tofergregg/IBM-Wheelwriter-Hack/hardware/Arduino_NanoShield/meta/info.html

This project template is the basis of an expansion board for the Arduino Nano (http://arduino.cc/en/Main/ArduinoBoardNano)

This base project includes a PCB edge defined as the same
size as the Arduino Nano 2 PCB with the connectors placed
correctly to align the two boards.

Contours and holes can be easely modified, just remove line or hole
and redraw wath you want in layer "edge.cuts".
In layer "Dwgs.User" you have the position of Reset button,
USB, ISP and Power connector,

The final PCB looks like the following:

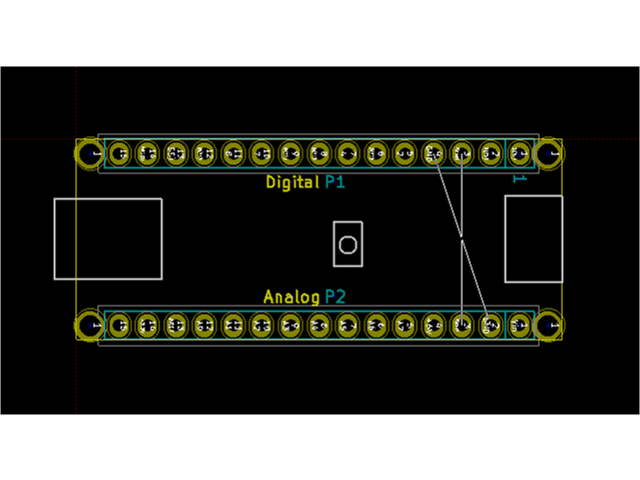
[picture p4: hardware/Arduino_NanoShield/meta/brd.png]


(c)2015 Jonathan Iapicco.
