tofergregg/IBM-Wheelwriter-Hack/images/case_in_line.pdf

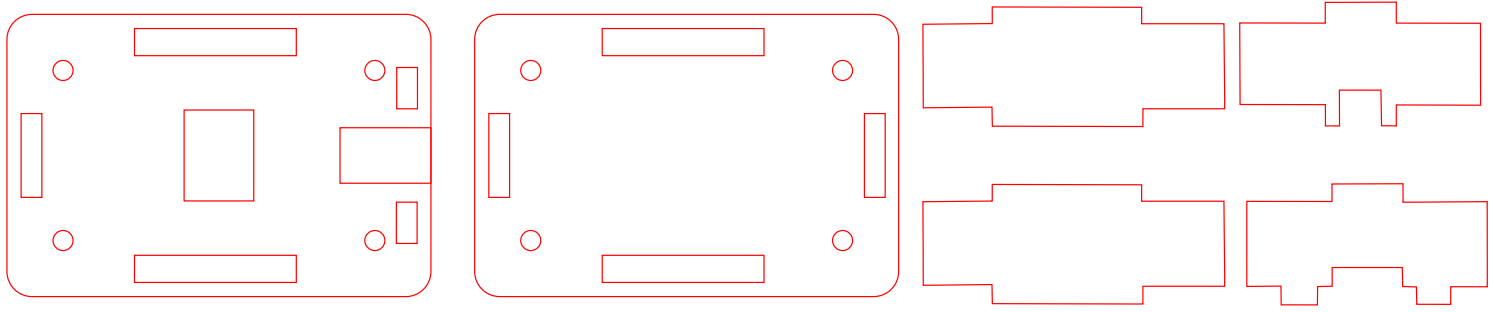
[picture p5: figure]
