tofergregg/IBM-Wheelwriter-Hack/FlatFlexPassthrough/flatflex_cable.jpg

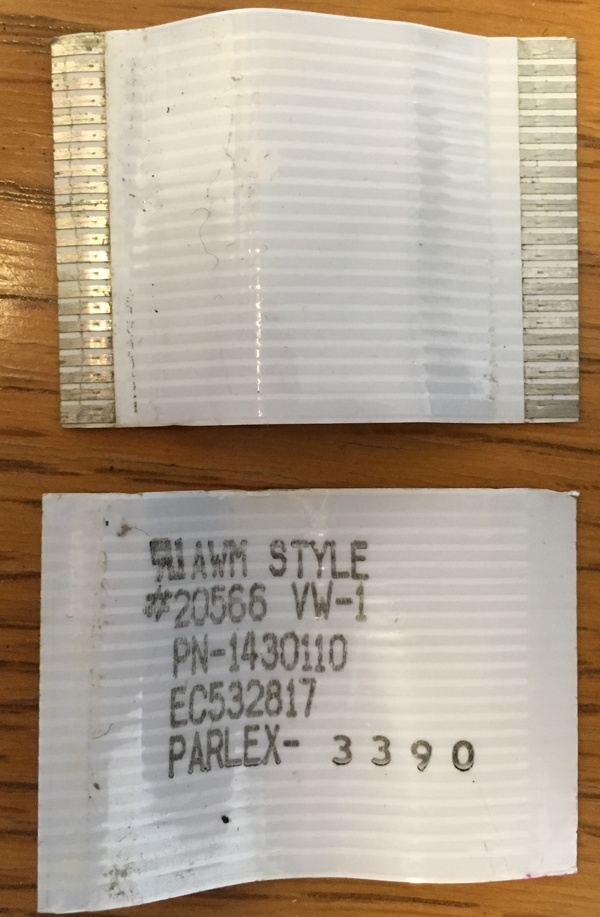
FlatFlexPassthrough/flatflex_cable.jpg
