tofergregg/IBM-Wheelwriter-Hack/images/earth.png

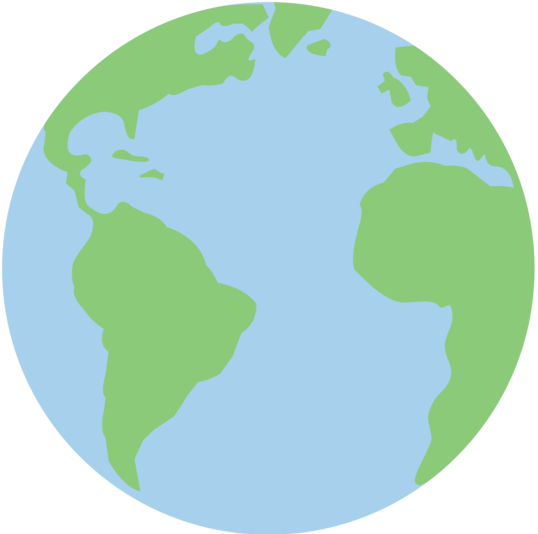
images/earth.png
