tofergregg/IBM-Wheelwriter-Hack/images/happyMac.jpg

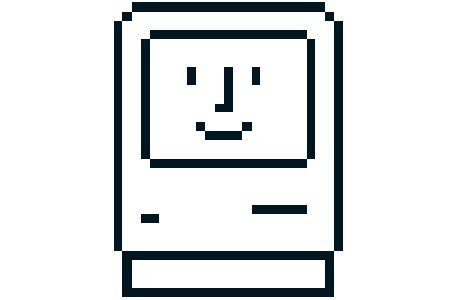
images/happyMac.jpg
