tofergregg/IBM-Wheelwriter-Hack/images/mario.png

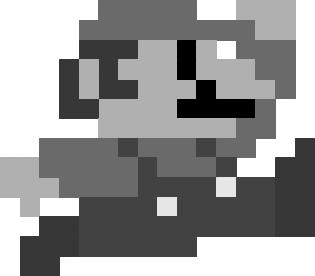
images/mario.png
