tofergregg/IBM-Wheelwriter-Hack/images/smiley.png

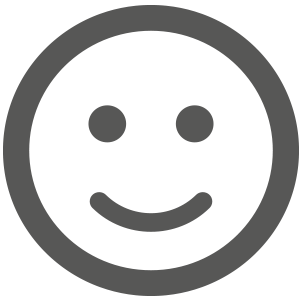
images/smiley.png
