tofergregg/IBM-Wheelwriter-Hack/images/wreck-it-ralph.gif

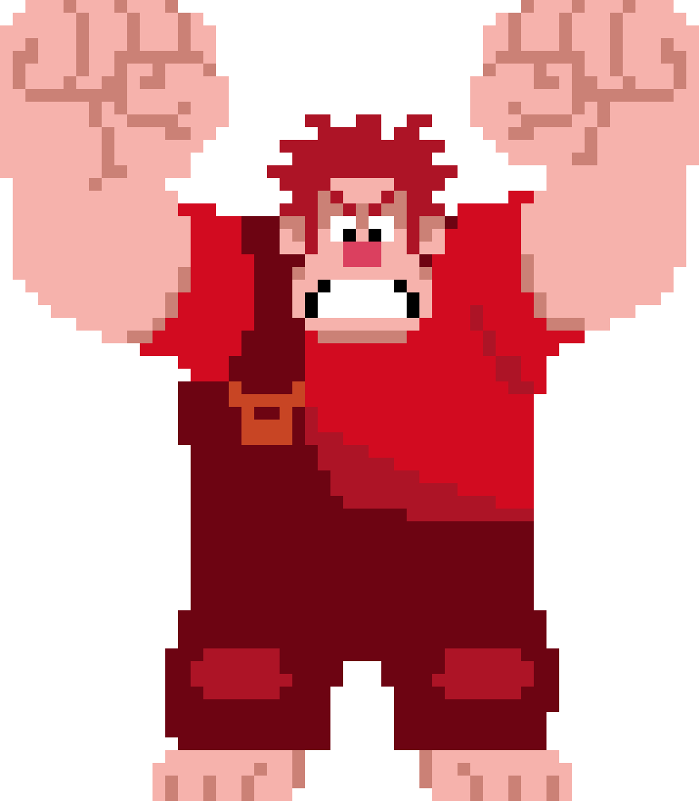
images/wreck-it-ralph.gif
