tofergregg/IBM-Wheelwriter-Hack/ROM/flex1.jpg

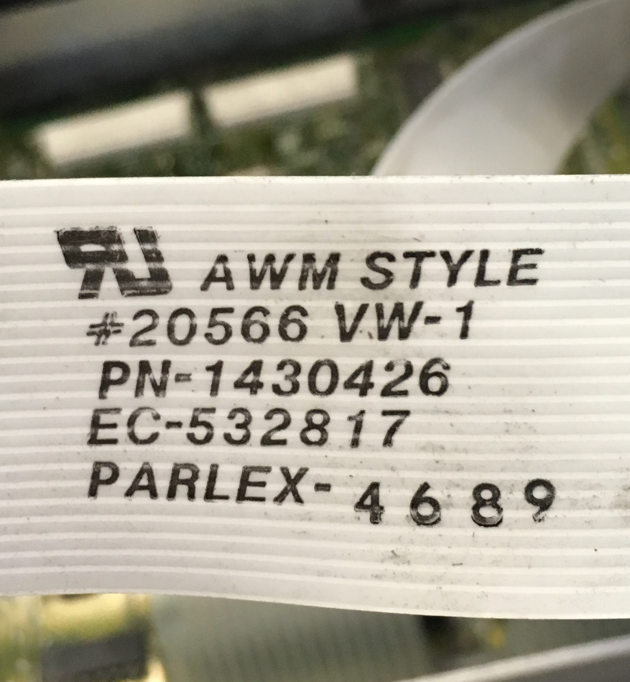
ROM/flex1.jpg
