tofergregg/IBM-Wheelwriter-Hack/ROM/flex2.jpg

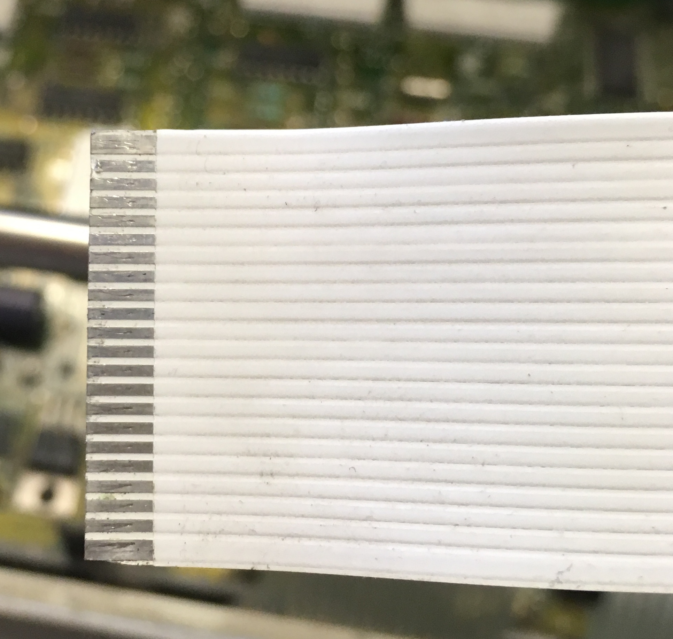
ROM/flex2.jpg
