tofergregg/IBM-Wheelwriter-Hack/ROM/full-pcb-board.jpg

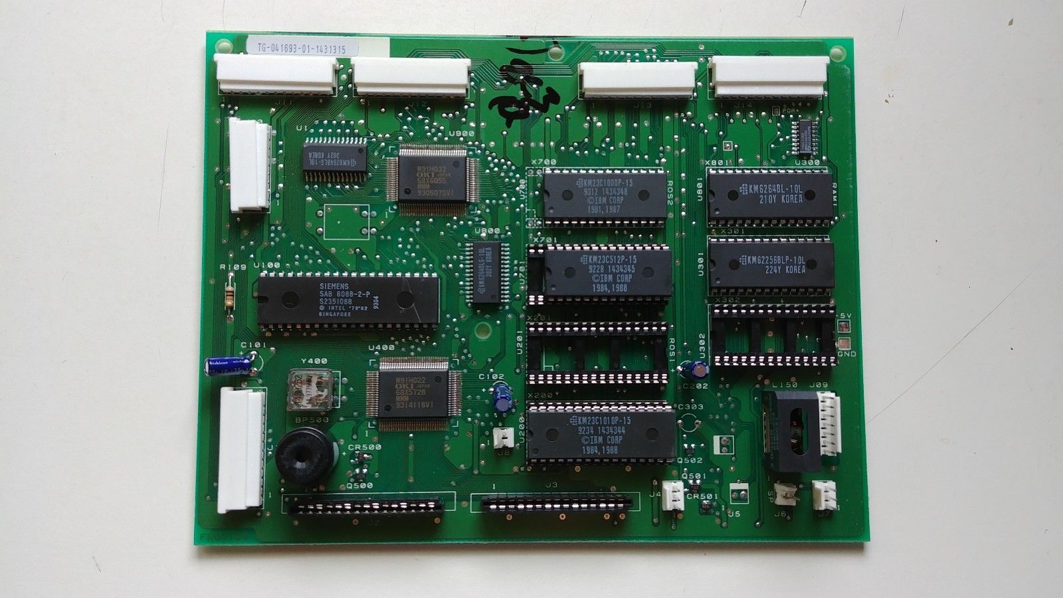
ROM/full-pcb-board.jpg
