tofergregg/IBM-Wheelwriter-Hack/software/IBM Wheelwriter Word Processor/bold.png

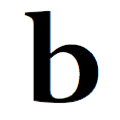
software/IBM Wheelwriter Word Processor/bold.png
