tofergregg/IBM-Wheelwriter-Hack/software/IBM Wheelwriter Word Processor/margins.png

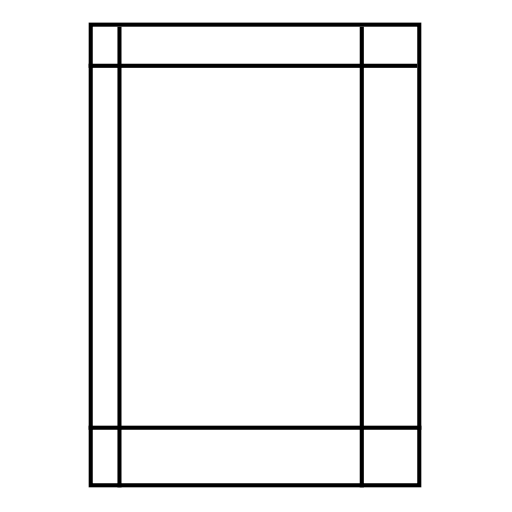
software/IBM Wheelwriter Word Processor/margins.png
