tofergregg/IBM-Wheelwriter-Hack/software/IBM Wheelwriter Word Processor/typewriter.png

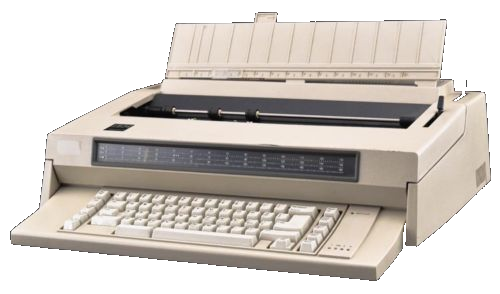
software/IBM Wheelwriter Word Processor/typewriter.png
