tofergregg/IBM-Wheelwriter-Hack/software/IBM Wheelwriter Word Processor/underline.png

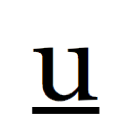
software/IBM Wheelwriter Word Processor/underline.png
