tofergregg/IBM-Wheelwriter-Hack/reverse_engineering/letters/Logic/imagePrint/2x2.csv

Time[s] | Channel 7
-0.100000000000000 | 1
0.000000000000000 | 0
0.000005000000000 | 1
0.000009750000000 | 0
0.000030000000000 | 1
0.000035750000000 | 0
0.000046000000000 | 1
0.000119500000000 | 0
0.000173000000000 | 1
0.000179250000000 | 0
0.000184250000000 | 1
0.000195000000000 | 0
0.000200000000000 | 1
0.000205750000000 | 0
0.000232000000000 | 1
0.000365000000000 | 0
0.000418250000000 | 1
0.000424500000000 | 0
0.000429500000000 | 1
0.000434250000000 | 0
0.000454500000000 | 1
0.000460250000000 | 0
0.000470500000000 | 1
0.000525000000000 | 0
0.000578250000000 | 1
0.000584500000000 | 0
0.000589500000000 | 1
0.000594250000000 | 0
0.000604500000000 | 1
0.000610250000000 | 0
0.000636250000000 | 1
0.000759500000000 | 0
0.000813000000000 | 1
0.000819000000000 | 0
0.000870000000000 | 1
0.000908750000000 | 0
0.000962250000000 | 1
0.000968500000000 | 0
0.000973500000000 | 1
0.000978250000000 | 0
0.000998500000000 | 1
0.001004250000000 | 0
0.001014500000000 | 1
0.001154250000000 | 0
0.001207500000000 | 1
0.001213750000000 | 0
0.001223750000000 | 1
0.001229500000000 | 0
0.001234750000000 | 1
0.001240500000000 | 0
0.001266500000000 | 1
0.001324750000000 | 0
0.001378250000000 | 1
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
