tofergregg/IBM-Wheelwriter-Hack/reverse_engineering/letters/Logic/imagePrint/abcde.csv

Time[s] | Channel 7
-0.100000000000000 | 1
0.000000000000000 | 0
0.000005000000000 | 1
0.000009750000000 | 0
0.000030000000000 | 1
0.000035750000000 | 0
0.000045750000000 | 1
0.000129500000000 | 0
0.000182750000000 | 1
0.000189000000000 | 0
0.000194250000000 | 1
0.000204750000000 | 0
0.000210000000000 | 1
0.000215750000000 | 0
0.000241750000000 | 1
0.000310750000000 | 0
0.000364250000000 | 1
0.000370250000000 | 0
0.000375250000000 | 1
0.000380000000000 | 0
0.000400250000000 | 1
0.000406000000000 | 0
0.000416250000000 | 1
0.000534750000000 | 0
0.000588000000000 | 1
0.000594250000000 | 0
0.000599250000000 | 1
0.000610000000000 | 0
0.000646000000000 | 1
0.000705250000000 | 0
0.000758750000000 | 1
0.000764750000000 | 0
0.000770000000000 | 1
0.000774500000000 | 0
0.000815750000000 | 1
0.000908000000000 | 0
0.000961500000000 | 1
0.000967500000000 | 0
0.000977500000000 | 1
0.000983250000000 | 0
0.000988500000000 | 1
0.000994250000000 | 0
0.001020250000000 | 1
0.001052000000000 | 0
0.001105250000000 | 1
0.422538000000000 | 0
0.422543000000000 | 1
0.422547750000000 | 0
0.422568000000000 | 1
0.422573750000000 | 0
0.422584000000000 | 1
0.422658500000000 | 0
0.422711750000000 | 1
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
