tofergregg/IBM-Wheelwriter-Hack/FlatFlexPassthrough/printer_board.jpg

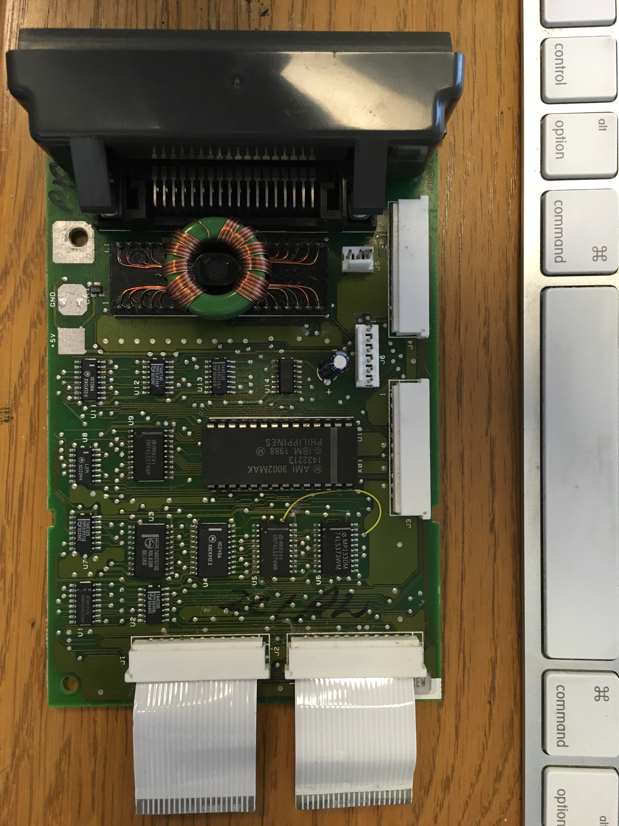
FlatFlexPassthrough/printer_board.jpg
