tofergregg/IBM-Wheelwriter-Hack/PrinterOption/testLinefeed.txt

This is a line of text.
JThis is a line of text.
The above lines should have printed twice but the
second line should have been 3 "pixels" lower.
This is another line of text.
JThis is another line of text.
The above lines should have printed twice but the
second line should have been 6 "pixels" lower.
This is another line of text.
JThis is another line of text.
The above lines should have printed twice but the
second line should have been 1 "pixel" lower.
