tofergregg/IBM-Wheelwriter-Hack/PrinterOption/test.txt

This is some stanard text without the carriage return.
So, we can pipe through sed to print correctly.
