tofergregg/IBM-Wheelwriter-Hack/PrinterOption/testBold.txt

This is regular text.

Ethis is boldF

this should not be bold
