tofergregg/IBM-Wheelwriter-Hack/PrinterOption/testEscapeCodes.txt

This is regular text.

Ethis is bold.F

this should not be bold.

-1this should be underlined.-0

this should not be underlined.

This should be ten squared plus five: 10S02T + 5

This should be water: HS12TO

This should be regular again.
