tofergregg/IBM-Wheelwriter-Hack/PrinterOption/testSuperscript.txt

This is regular text.

This should be ten squared plus five: 10S02T + 5

This should be water: HS12TO

This should be regular text again
