tofergregg/IBM-Wheelwriter-Hack/PrinterOption/testUnderline.txt

This is regular text.

this should be underlined
____ ______ __ __________

This should be regular again.

-1This should be underlined again.-0

This should not be underlined.
