tofergregg/IBM-Wheelwriter-Hack/reverse_engineering/letters/Logic/fast/test.txt

this is a fast test
and another fast line
and another.
