tofergregg/IBM-Wheelwriter-Hack/reverse_engineering/letters/Logic/13aBeanTest.csv

Time[s] | Channel 7
-0.100000000000000 | 1
0.000000000000000 | 0
0.000005250000000 | 1
0.000010000000000 | 0
0.000030250000000 | 1
0.000036000000000 | 0
0.000046000000000 | 1
0.000190750000000 | 0
0.000244250000000 | 1
0.020065000000000 | 0
0.020070000000000 | 1
0.020080750000000 | 0
0.020085750000000 | 1
0.020091500000000 | 0
0.020117500000000 | 1
0.020198750000000 | 0
0.020252000000000 | 1
0.021581000000000 | 0
0.021586250000000 | 1
0.021591000000000 | 0
0.021611000000000 | 1
0.021616750000000 | 0
0.021627000000000 | 1
0.021771750000000 | 0
0.021825250000000 | 1
0.021833750000000 | 0
0.021838750000000 | 1
0.021849500000000 | 0
0.021885500000000 | 1
0.021947750000000 | 0
0.022001000000000 | 1
0.022086250000000 | 0
0.022091500000000 | 1
0.022096250000000 | 0
0.022137250000000 | 1
0.022171750000000 | 0
0.022225000000000 | 1
0.022338250000000 | 0
0.022348250000000 | 1
0.022354000000000 | 0
0.022359250000000 | 1
0.022365000000000 | 0
0.022391000000000 | 1
0.022422250000000 | 0
0.022475750000000 | 1
0.172621750000000 | 0
0.172627000000000 | 1
0.172631750000000 | 0
0.172652000000000 | 1
0.172657500000000 | 0
0.172667750000000 | 1
0.192683000000000 | 0
0.192688000000000 | 1
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
