tofergregg/IBM-Wheelwriter-Hack/(threads)

Thread 2 (2017-02-06):

Schematic Documentation

Cabalist, 2017-02-06:
Would you consider adding some documentation about the circuit to the README?  The KiCAD files are great but I think for newbies it would be helpful to have a parts list and a picture of the circuit in the README.

Thanks!

Cabalist, 2017-02-06:
Related question.  You have +5v marked on the pinout of the connector to the typewriter and I currently have that disconnected and I'm not having any issues.   *Should* it be attached to something?

tofergregg, 2017-02-06:
Hi there -- sure, I could put documentation into the README. I'm glad you've got it working! No, actually the the 5V on the board was originally to power the Arduino, but then I realized that it wasn't necessary if you have USB power, which you'll have if you are using the port for serial access.

Please keep me posted on how it is going! Let me know if there are any issues. May I ask, what model Wheelwriter do you have? I am trying to compile a list of compatible models, and so far I only have my own Wheelwriter 6 on the list. Cheers!

Cabalist, 2017-02-06:
I've got a Wheelwriter 6 as well.  And a Wheelwriter 2 on the way.

I love your project and will keep you updated of any changes.  😃

tofergregg, 2017-02-06:
Great -- thank you!

tofergregg, 2017-02-09:
I put the breadboard diagram online, and updated the README with more information. Let me know if that works. Cheers!

Cabalist, 2017-02-10:
Love all the new info.

tofergregg, 2017-02-10:
Thanks -- let me know if you see anything else that needs changing / updating, or if you have suggestions. Incidentally, are you a Mac / Windows / Linux user?

Cabalist, 2017-02-10:
Mac/Linux

Will do on the suggestion front. I am going on a drive tomorrow to go pick
up a Wheelwriter 2 to see about compatibility.  I'm hacking away over here
and will put up the code I have soon.  I am working on a webclient and a
standalone unit.  :)

On Fri, Feb 10, 2017 at 6:45 AM, Chris Gregg <notifications@github.com>
wrote:

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

tofergregg, 2017-02-10:
Re: Web client -- awesome. Please let me know about compatibility with the Wheelwriter 2! I got a note from someone with a Wheelwriter 30 (a Lexmark variety?), and it doesn't look like it has an easily accessible port. Hopefully I can check that out at some point.

Closed 2017-02-09.

Thread 3 (2017-02-12):

Wheelwriter 5 Support

Cabalist, 2017-02-12:
Hey There,

I just confirmed Wheelwriter 5 support.  😀

Attached are some board shots.   The pinout of the connector appears to be the same and it immediately typed out some demo text for me without any adjustments to the code!

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

tofergregg, 2017-02-12:
Awesome! Thanks for the update, and very nice photos. Cheers!

Closed 2017-02-28.

Thread 5 (2017-02-12):

Complete Font Table

Cabalist, 2017-02-12:
I've managed to get my hands on 5 different font wheels.  I went through and compared all of them and found some omissions and errors in the asciiTrans section of the Arduino code.

All font wheels have the same characters and sadly there are no curly braces to be found.  Quine will not be possible in C 😉

This is the COMPLETE font table.  I went through the wheels by hand and looked at every letter.  There may be different WAYS of typing to discover but there aren't different THINGS to type.

My summary follows:

| Sequence | Hex  | Elite (1353861)| Title (1353952) | Delegate (1353843) | Courier 10 (1353511) | Prestige Elite (1353502)|                             |
|----------|------|-------|-------|----------|------------|----------------|-----------------------------|
| 1        | 0x01 | a     | a     | a        | a          | a              |                             |
| 2        | 0x02 | n     | n     | n        | n          | n              |                             |
| 3        | 0x03 | r     | r     | r        | r          | r              |                             |
| 4        | 0x04 | m     | m     | m        | m          | m              |                             |
| 5        | 0x05 | c     | c     | c        | c          | c              |                             |
| 6        | 0x06 | s     | s     | s        | s          | s              |                             |
| 7        | 0x07 | d     | d     | d        | d          | d              |                             |
| 8        | 0x08 | h     | h     | h        | h          | h              |                             |
| 9        | 0x09 | l     | l     | l        | l          | l              |                             |
| 10       | 0x0A | f     | f     | f        | f          | f              |                             |
| 11       | 0x0B | k     | k     | k        | k          | k              |                             |
| 12       | 0x0C | ,     | ,     | ,        | ,          | ,              |                             |
| 13       | 0x0D | V     | V     | V        | V          | V              |                             |
| 14       | 0x0E | -     | -     | -        | -          | -              |                             |
| 15       | 0x0F | G     | G     | G        | G          | G              |                             |
| 16       | 0x10 | U     | U     | U        | U          | U              |                             |
| 17       | 0x11 | F     | F     | F        | F          | F              |                             |
| 18       | 0x12 | B     | B     | B        | B          | B              |                             |
| 19       | 0x13 | Z     | Z     | Z        | Z          | Z              |                             |
| 20       | 0x14 | H     | H     | H        | H          | H              |                             |
| 21       | 0x15 | P     | P     | P        | P          | P              |                             |
| 22       | 0x16 | )     | )     | )        | )          | )              |                             |
| 23       | 0x17 | R     | R     | R        | R          | R              |                             |
| 24       | 0x18 | L     | L     | L        | L          | L              |                             |
| 25       | 0x19 | S     | S     | S        | S          | S              |                             |
| 26       | 0x1A | N     | N     | N        | N          | N              |                             |
| 27       | 0x1B | C     | C     | C        | C          | C              |                             |
| 28       | 0x1C | T     | T     | T        | T          | T              |                             |
| 29       | 0x1D | D     | D     | D        | D          | D              |                             |
| 30       | 0x1E | E     | E     | E        | E          | E              |                             |
| 31       | 0x1F | I     | I     | I        | I          | I              |                             |
| 32       | 0x20 | A     | A     | A        | A          | A              |                             |
| 33       | 0x21 | J     | J     | J        | J          | J              |                             |
| 34       | 0x22 | O     | O     | O        | O          | O              |                             |
| 35       | 0x23 | (     | (     | (        | (          | (              |                             |
| 36       | 0x24 | M     | M     | M        | M          | M              |                             |
| 37       | 0x25 | .     | .     | .        | .          | .              | Missing (duplicate of 0x57) |
| 38       | 0x26 | Y     | Y     | Y        | Y          | Y              |                             |
| 39       | 0x27 | ,     | ,     | ,        | ,          | ,              | Missing (duplicate of 0x0C) |
| 40       | 0x28 | /     | /     | /        | /          | /              |                             |
| 41       | 0x29 | W     | W     | W        | W          | W              |                             |
| 42       | 0x2A | 9     | 9     | 9        | 9          | 9              |                             |
| 43       | 0x2B | K     | K     | K        | K          | K              |                             |
| 44       | 0x2C | 3     | 3     | 3        | 3          | 3              |                             |
| 45       | 0x2D | X     | X     | X        | X          | X              |                             |
| 46       | 0x2E | 1     | 1     | 1        | 1          | 1              |                             |
| 47       | 0x2F | 2     | 2     | 2        | 2          | 2              |                             |
| 48       | 0x30 | 0     | 0     | 0        | 0          | 0              |                             |
| 49       | 0x31 | 5     | 5     | 5        | 5          | 5              |                             |
| 50       | 0x32 | 4     | 4     | 4        | 4          | 4              |                             |
| 51       | 0x33 | 6     | 6     | 6        | 6          | 6              |                             |
| 52       | 0x34 | 8     | 8     | 8        | 8          | 8              |                             |
| 53       | 0x35 | 7     | 7     | 7        | 7          | 7              |                             |
| 54       | 0x36 | *     | *     | *        | *          | *              |                             |
| 55       | 0x37 | $     | $     | $        | $          | $              |                             |
| 56       | 0x38 | #     | #     | #        | #          | #              |                             |
| 57       | 0x39 | %     | %     | %        | %          | %              |                             |
| 58       | 0x3A | ¢     | ¢     | ¢        | ¢          | ¢              | Missing                     |
| 59       | 0x3B | +     | +     | +        | +          | +              |                             |
| 60       | 0x3C | ±     | ±     | ±        | ±          | ±              | Missing                     |
| 61       | 0x3D | @     | @     | @        | @          | @              |                             |
| 62       | 0x3E | Q     | Q     | Q        | Q          | Q              |                             |
| 63       | 0x3F | &     | &     | &        | &          | &              |                             |
| 64       | 0x40 | ]     | ]     | ]        | ]          | ]              |                             |
| 65       | 0x41 | [     | [     | [        | [          | [              |                             |
| 66       | 0x42 | ²     | ²     | ²        | ²          | ²              | Missing                     |
| 67       | 0x43 | ³     | ³     | ³        | ³          | ³              | Missing                     |
| 68       | 0x44 | °     | °     | °        | °          | °              | Missing                     |
| 69       | 0x45 | §     | §     | §        | §          | §              | Missing                     |
| 70       | 0x46 | ¶     | ¶     | ¶        | ¶          | ¶              | Missing                     |
| 71       | 0x47 | ½     | ½     | ½        | ½          | ½              | Missing                     |
| 72       | 0x48 | ¼     | ¼     | ¼        | ¼          | ¼              | Missing                     |
| 73       | 0x49 | !     | !     | !        | !          | !              |                             |
| 74       | 0x4A | ?     | ?     | ?        | ?          | ?              |                             |
| 75       | 0x4B | "     | "     | "        | "          | "              |                             |
| 76       | 0x4C | '     | '     | '        | '          | '              |                             |
| 77       | 0x4D | =     | =     | =        | =          | =              |                             |
| 78       | 0x4E | :     | :     | :        | :          | :              |                             |
| 79       | 0x4F | _     | _     | _        | _          | _              |                             |
| 80       | 0x50 | ;     | ;     | ;        | ;          | ;              |                             |
| 81       | 0x51 | x     | x     | x        | x          | x              |                             |
| 82       | 0x52 | q     | p     | p        | p          | p              |                             |
| 83       | 0x53 | v     | v     | v        | v          | v              |                             |
| 84       | 0x54 | z     | z     | z        | z          | z              |                             |
| 85       | 0x55 | w     | w     | w        | w          | w              |                             |
| 86       | 0x56 | j     | j     | j        | j          | j              |                             |
| 87       | 0x57 | .     | .     | .        | .          | .              |                             |
| 88       | 0x58 | y     | y     | y        | y          | y              |                             |
| 89       | 0x59 | b     | d     | d        | d          | d              |                             |
| 90       | 0x5A | g     | g     | g        | g          | g              |                             |
| 91       | 0x5B | u     | u     | u        | u          | u              |                             |
| 92       | 0x5C | p     | q     | q        | q          | q              |                             |
| 93       | 0x5D | i     | i     | i        | i          | i              |                             |
| 94       | 0x5E | t     | t     | t        | t          | t              |                             |
| 95       | 0x5F | o     | o     | o        | o          | o              |                             |
| 96       | 0x60 | e     | e     | e        | e          | e              |                             |

Cabalist, 2017-02-12:
It is also worth noting that there are other very different fonts that were made available

Such as:
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

I am thinking a Compatibility table is in the future with Model and Printwheels...

tofergregg, 2017-02-12:
Wow -- thanks for the updated information (wait a minute...did you outbid me on an eBay listing for those wheels?? -- it looks like that listing included Letter Gothic, so probably not).

I'm surprised Courier doesn't have curly braces (did they really need § and ¶ ?). I was sure there would be modified letters (the Arabic wheel shows that there are completely different wheels). Alas.

I'm still flummoxed by the encoding (i.e., why 'a' is 0x1, b is 0x59, etc.). I wonder if it has to do with the frequency of letters in English -- having x, q, v, z, and w near each other is suspect, as is having i, t, o, and e next to each other. If we could only track down an engineer who originally worked on the Wheelwriter design...

Cabalist, 2017-02-12:
Oh!  The Encoding is actually really simple and I meant to point it out in the original post.  a is the first letter on the wheel, n is the second, etc.  There are 96 symbols on each wheel.   Haha.

Cabalist, 2017-02-12:
I've got 5 wheels if you would like me to send you one I totally can.

tofergregg, 2017-02-12:
Ah -- so interesting. I just looked at the wheel on mine and I see what you mean. I have a feeling that the code itself is related to letter frequency, because the top keys are aeoti (to the left) and rmcsb (to the right) -- pretty common letters.

No worries about the wheel -- I will get one soon. Thanks, though!

Cabalist, 2017-02-12:
Here are some updated examples of asciiTrans with formatting.  asciiTrans is kind of a misnomer as this has non-ascii symbols and is missing ascii symbols.   Maybe symbolTrans instead?

Sequential Order
```C
int asciiTrans[96] =
//   a        n        r        m        c        s        d        h
   {0x01,    0x02,    0x03,    0x04,    0x05,    0x06,    0x07,    0x08,
//   l        f        k        ,        V        -        G        U
    0x09,    0x0A,    0x0B,    0x0C,    0x0D,    0x0E,    0x0F,    0x10,
//   F        B        Z        H        P        )        R        L
    0x11,    0x12,    0x13,    0x14,    0x15,    0x16,    0x17,    0x18,
//   S        N        C        T        D        E        I        A
    0x19,    0x1A,    0x1B,    0x1C,    0x1D,    0x1E,    0x1F,    0x20,
//   J        O        (        M        .        Y        ,        /
    0x21,    0x22,    0x23,    0x24,    0x25,    0x26,    0x27,    0x28,
//   W        9        K        3        X        1        2        0
    0x29,    0x2A,    0x2B,    0x2C,    0x2D,    0x2E,    0x2F,    0x30,
//   5        4        6        8        7        *        $        #
    0x31,    0x32,    0x33,    0x34,    0x35,    0x36,    0x37,    0x38,
//   %        ¢        +        ±        @        Q        &        ]
    0x39,    0x3A,    0x3B,    0x3C,    0x3D,    0x3E,    0x3F,    0x40,
//   [        ²        ³        °        §        ¶        ½        ¼
    0x41,    0x42,    0x43,    0x44,    0x45,    0x46,    0x47,    0x48,
//   !        ?        "        '        =        :        _        ;
    0x49,    0x4A,    0x4B,    0x4C,    0x4D,    0x4E,    0x4F,    0x50,
//   x        q        v        z        w        j        .        y
    0x51,    0x52,    0x53,    0x54,    0x55,    0x56,    0x57,    0x58,
//   b        g        u        p        i        t        o        e
    0x59,    0x5A,    0x5B,    0x5C,    0x5D,    0x5E,    0x5F,    0x60}
```
Symbol order with grouping
```C
int asciiTrans[96] =
//   A        B        C        D        E        F        G        H
   {0x20,    0x12,    0x1B,    0x1D,    0x1E,    0x11,    0x0F,    0x14,
//   I        J        K        L        M        N        O        P
    0x1F,    0x21,    0x2B,    0x18,    0x24,    0x1A,    0x22,    0x15,
//   Q        R        S        T        U        V        W        X
    0x3E,    0x17,    0x19,    0x1C,    0x10,    0x0D,    0x29,    0x2D,
//   Y        Z        a        b        c        d        e        f
    0x26,    0x13,    0x01,    0x59,    0x05,    0x07,    0x60,    0x0A,
//   g        h        i        j        k        l        m        n
    0x5A,    0x08,    0x5D,    0x56,    0x0B,    0x09,    0x04,    0x02,
//   o        p        q        r        s        t        u        v
    0x5F,    0x5C,    0x52,    0x03,    0x06,    0x5E,    0x5B,    0x53,
//   w        x        y        z
    0x55,    0x51,    0x58,    0x54,

//   0        1        2        3        4        5        6        7
    0x30,    0x2E,    0x2F,    0x2C,    0x32,    0x31,    0x33,    0x35,
//   8        9
    0x34,    0x2A,

//   !        "        #        $        %        &        '        (
    0x49,    0x4B,    0x38,    0x37,    0x39,    0x3F,    0x4C,    0x23,
//   )        *        +        ,        ,        -        .        .
    0x16,    0x36,    0x3B,    0x27,    0x0C,    0x0E,    0x57,    0x25,
//   /        :        ;        =        ?        @        [        ]
    0x28,    0x4E,    0x50,    0x4D,    0x4A,    0x3D,    0x41,    0x40,
//   _        ¢        §        °        ±        ²        ³        ¶
    0x4F,    0x3A,    0x45,    0x44,    0x3C,    0x42,    0x43,    0x46,
//   ¼        ½
    0x48,    0x47}
 ```

Symbol order without grouping:
```C
int asciiTrans[96] =
//   A        B        C        D        E        F        G        H
   {0x20,    0x12,    0x1B,    0x1D,    0x1E,    0x11,    0x0F,    0x14,
//   I        J        K        L        M        N        O        P
    0x1F,    0x21,    0x2B,    0x18,    0x24,    0x1A,    0x22,    0x15,
//   Q        R        S        T        U        V        W        X
    0x3E,    0x17,    0x19,    0x1C,    0x10,    0x0D,    0x29,    0x2D,
//   Y        Z        a        b        c        d        e        f
    0x26,    0x13,    0x01,    0x59,    0x05,    0x07,    0x60,    0x0A,
//   g        h        i        j        k        l        m        n
    0x5A,    0x08,    0x5D,    0x56,    0x0B,    0x09,    0x04,    0x02,
//   o        p        q        r        s        t        u        v
    0x5F,    0x5C,    0x52,    0x03,    0x06,    0x5E,    0x5B,    0x53,
//   w        x        y        z        0        1        2        3
    0x55,    0x51,    0x58,    0x54,    0x30,    0x2E,    0x2F,    0x2C,
//   4        5        6        7        8        9        !        "
    0x32,    0x31,    0x33,    0x35,    0x34,    0x2A,    0x49,    0x4B,
//   #        $        %        &        '        (        )        *
    0x38,    0x37,    0x39,    0x3F,    0x4C,    0x23,    0x16,    0x36,
//   +        ,        ,        -        .        .        /        :
    0x3B,    0x27,    0x0C,    0x0E,    0x57,    0x25,    0x28,    0x4E,
//   ;        =        ?        @        [        ]        _        ¢
    0x50,    0x4D,    0x4A,    0x3D,    0x41,    0x40,    0x4F,    0x3A,
//   §        °        ±        ²        ³        ¶        ¼        ½
    0x45,    0x44,    0x3C,    0x42,    0x43,    0x46,    0x48,    0x47}
```

bitcraft, 2017-02-28:
nice work!

tofergregg, 2017-02-28:
I just received an OCR-A wheel, and interestingly, there are some differences. Funnily enough, there _are_ curly braces, but you use the parentheses keys, so there aren't any parentheses! At least I haven't found them yet. :/

There aren't any square brackets, either, nor an exclamation point, nor an underscore. So, my idea to print code with the typewriter seems slim at this point.

RussellSenior, 2020-04-26:
According to https://typewriters.com/supplies/genuine-ibm-printwheel/ there are "ASCII" printwheels. I have yet to actually find one available anywhere, but they seem to have existed at some point (e.g. Courier 10 ASCII DP, Letter Gothic ASCII, Prestige Elite 12 ASCII)

RussellSenior, 2020-06-14:
I did finally score a Courier 10 DP, 1353909, which has the full ASCII character set. See: https://github.com/RussellSenior/ww5teletype/blob/master/doc/printwheel-map-with-option-board-codes.txt

RussellSenior, 2020-06-14:
And @Cabalist, fyi, I'm just across the river from you in Portland.

Thread 6 (2017-02-12):

Printwheel Detection

Cabalist, 2017-02-12:
According to the manual different printwheels have different pitches.  The options are:

Pitch |	Type Size |	Characters per inch | Lines per vertical inch
-- | -- | --| --
Pica	|10|	10|6|
Elite	|12|	12| 6
Proportional Spacing	|PS|	Varies | 6
Micro Elite	|15|	15|8

When you install a printwheel the typewriter is able to automatically adjust to the printwheel.  They appear to have some cutouts in the center that assist in this.
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
Notice the 4 holes around the perimeter above
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
Only three here

According to the manual the following things are set:

 - Pitch
 - Margins
 - Tabs
 - Impression

Wondering out loud if we can detect those as well and adjust so that images and text print consistently?

Also what is "Impression"?

tofergregg, 2017-02-12:
Hmm -- there is probably a way to detect the information, although it would be a matter of trying to capture the data through the bus (harder than it looks -- timing is critical, and I'm not 100% sure the Arduino can do it reliably, although I think we could get it to work). I captured the details of the start-up sequence in order to write the reset() function, and I believe I trimmed it down a bit, so that information may be passed on the bus. I'll get my hands on another wheel and see what I can figure out.

> what is impression

This seems to be how heavy the strike is (for thick forms, etc.). I haven't seen the setting on the typewriter keyboard, but if we can figure out how to make the typewriter adjust it, we can then have a setting for it.

Cabalist, 2017-02-12:
!! Interesting.  I would be curious how the startup sequence changes on different printwheels and if reseting the typewriter with a different printwheel in it will make it act kooky.

Also have you seen this:  https://en.wikipedia.org/wiki/8b/10b_encoding

tofergregg, 2017-02-12:
I have a feeling that resetting the typewriter makes it read the current print wheel. If you take out the print wheel while the typewriter is on and then replace it, it does a reset on its own before printing again.

bitcraft, 2017-02-28:
The cutouts that you mentioned are different for each print wheel.  As the wheel is turned, the holes are detected by an optical sensor on the carriage.  The typewriter must have an internal memory of each wheel, and can detect the layout of it by the encoded data on the wheel.

I'm not sure that the wheel information is sent out on the data bus....I've never seen it referenced anywhere.  However, it might be possible to prevent only a specific print wheel to be used by using special control codes.  I don't have references handy, but you could emulate the stored document behavior of the disk drive to ensure the correct print wheel is installed.

On memory models with a disk drive, it is possible to create documents with specific print wheels, and the typewriter firmware has the ability to detect what print wheel is needed in the document.  By isolating the codes, it might be possible to tell the typewrite to only use a specific print wheel.

Hope that helps.

jim121049, 2018-11-24:
I believe is is possible to detect what type of printwheel is in use (at least the pitch). Send to the Wheelwriter (over the bus) 0x121 followed by 0x008. The Wheelwriter spins the printwheel and then returns (on the bus) one 9 bit word indicating the pitch of the printwheel installed: 0x040 for 10 cpi printwheels, 0x020 for 12 cpi printwheels, and 0x021 for no printwheel. I've ordered 15cpi and PS printwheels from eBay. When they finally arrive, I'll report what they return.

On a related note, I've abandoned the Arduino platform for interfacing with the Wheelwriter. Try as I might, I was never able to get an Arduino to reliably read data on the Wheelwriter bus. I'm now using a Dallas Semiconductor DS89C440 (an Intel 8052 derivative) with its second of two UARTs connected to the bus and configured for serial mode 2 (1 start bit, 9 data bits, 1 stop bit). This is the same UART configuration that the 8051s on the function and printer boards use. Works like a champ.

jim121049, 2018-11-25:
Just a note about impression control above.  Code Q is used to toggle between "normal" and "heavy" impression. The "Q" key is labeled "Impr" on Series II machines.
0x121,0x009,0x001 selects "heavy. 0x121,0x009,0x000 selects "normal" impression.

Thread 7 (2017-02-28):

Information on wheelwriter

bitcraft, 2017-02-28:
No issue to raise.  I have a WW 3 and a WW 3500 that I've been repairing slowly and I'm interested in the project you've got going.  I found the following pdf that is full of good information on the overall design of the WW.  The most relevant to this project information is about the data bus.

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

From my own tinkering and from reading of other sources, it seems that the keyboard generates WW specific control codes and then sends them on the bus.  The other devices, like the printer and floppy interface seem to just send the WW control codes, which you have begun to document.  I unfortunately could not find information about them online, and it seems that manual data bus logging will be the solution.

The floppy disk controller may very well be the key to unlocking the potential of your project.  By crafting a document that exposes all of the control codes, it would be possible to either sniff the data bus or simply read the contents of the floppy disk to figure out the protocol.

Just my thoughts.

https://drive.google.com/open?id=0B6n8Xp5V_REUN0g1X01DZ0JRd3M

tofergregg, 2017-02-28:
Very interesting -- thanks for the added information about the bus!

If you haven't seen the video yet of type typewriter in action, check it out here: https://www.youtube.com/watch?v=0vrvDQmZcPI

I agree that a floppy controller might be helpful, as would an actual print option card. For now, I've sussed out most of the functionality that I could expect, with the exception of getting the bell to ring (but I think that is not controlled through the bus).

Thread 8 (2017-03-03):

Print Speed

bitcraft, 2017-03-03:
I'm opening this issue for discussion about print speed.

I imagine that print speed can be considerably improved if we could reverse-engineer the protocol from a buffered memory device, such as the floppy disk drive, printer port, or even the built in memory on some models.  Instead of receiving keystrokes one at a time, the printing mechanism might work faster if it reads data the same way it would with the devices I mentioned.

As an aside, there is a 4865 disk drive on ebay now and I do have my eyes on it (I have a floppy disk controller card).  I'd hate to get into a bidding war with anyone else on this project.  So, unless it is really wanted by someone else here, I'd like to claim it...  I'm reasonable though!  I can forego bidding on it...  Just looking to avoid a unneeded bidding war.

Leif

tofergregg, 2017-03-03:
I think I've reverse-engineered the maximum print speed in the forward direction, and possibly the reverse direction for earlier wheel writers (WW 6 and lower). It uses the same function codes that the built-in centering function uses, and it is pretty fast (see the latest video: https://www.youtube.com/watch?v=0vrvDQmZcPI ). I have a hard time imagining that it could be faster for a couple of reasons -- first, I would assume that the centering function prints the characters as fast as possible, and there is a unique code to print a number of characters one-after-the-other. Second, a back-of-the-envelope calculation based on the radius of the wheel and motor speeds would indicate that it would be hard to make it much faster without running into physics issues.

As for printing backwards fast -- I know that later models do have backwards-printing functionality, and if I could figure out the code for that, it would be possible to print fast backwards (I believe it is probably an analogous command to the fast-forward printing). But, I don't have a typewriter that can do it natively, so I can't easily test it (though I suppose writing a script to simply loop through unknown commands would be possible, albeit slow if I have to continually hard-reset the typewriter).

bitcraft, 2017-03-03:
I don't have a data logger like yours.  Is it possible to use an arduino to log the data bus?  If so, maybe I could investigate reverse printing on my 3500.

tofergregg, 2017-03-03:
There is an Arduino library for logic analyzing, but I'm not sure how well it works: https://github.com/gillham/logic_analyzer

I'll see about getting my hands on a 3500 (or similar), too.

Thread 9 (2018-01-19):

Challenged builder needs some lables

budrow370, 2018-01-19:
On your image of the breadboard matrix with the 2n7002 with heat sink could you put a "S" "D" "G" over the proper pins for source, drain, and gate.  I tried to load kcad? or whatever to view the schematic but can't due to memory problems.  It would also be helpful to others in the same fix to do a screenshot of the schematic and post it as a simple .png so no cad software is needed to view it.  I am afraid my skill level is not high enough to figure out the circuit without a schematic.

Thanks

Buddy Bell

vollmster, 2018-06-03:
I know it's been a while since you asked this, but in case you didn't figure it out on your own, the datasheets on each MOSFETs have the information you're looking for.

As for the transistor on the breadboard, if that's the one you're interested in, it's not a 2N7002 (which is a surface mount part).

The closest through whole equivalent would be a 2N7000. In it's case, viewed from the front, left to right, the leads are SOURCE, GATE, DRAIN.

However, the MOSFET in the breadboard image isn't a 2N7000 (which doesn't have a visible heatsink). On a through hole transistor of this style, (3055VL works for example), the pin layout viewed left to right from the front, is GATE, DRAIN, SOURCE.

For the breadboard image, the MOSFET shown has a layout of GATE, DRAIN, SOURCE (like a 3055VL). So the 2N7002 is just a label for illustration.

If you're building an equivalent circuit of your own, just keep this in mind:

GATE: has the 200 Ohm resistor in line
DRAIN: goes to Bus pin 5 on the Wheelwriter and D3 on an Arduino
SOURCE: goes to Ground on the Wheelwriter and Arduino

Anyways, if you hadn't solved this already, I hope it helps.

Thread 10 (2018-11-24):

Wheelwriter Model Detection

jim121049, 2018-11-24:
It seems it may be possible to detect the Wheelwriter model. Send (on the bus) 0x121 followed by 0x000. I have two Model 3 Wheelwriters. They both return (on the bus) 0x006. I have a Model 6 Wheelwriter that returns 0x026. If someone has access to other models (Wheelwriter 5 or Series II models) it would be interesting to see what they return.

RussellSenior, 2020-05-29:
I have a Wheelwriter 5. The 0x121 0x00 command returns 0x25. I see this at power on.

tofergregg, 2020-05-29:
I'm sorry I missed the original comment -- this is a cool development!

RussellSenior, 2020-05-31:
FYI: this is from a year ago, https://github.com/RussellSenior/IBM-Wheelwriter-Hack/wiki/Bus-Protocol
I am using a Teensy 3.2 to listen/talk to the bus, which is nice because it can do native 9-bit serial at the required baud rate, and has 5V-tolerant digital pins. I'm using an SN74ALS38BN so I can isolate the RX from my own TX. I'm working towards replacing the function board with a Teensy 3.5 to read the keyboard and generate the right bus commands so I can use my WW5 as a kind of teleprinter.

RussellSenior, 2020-05-31:
Also: https://github.com/RussellSenior/ww5teletype/blob/master/doc/commands.txt (with various omissions, duplications and extensions)

Thread 13 (2020-09-23):

textToNano sending more bytes than expected

BlipRanger, 2020-09-23:
I've been doing some testing with the WheelwriterControlNano + textToNano and I noticed that on some files it skips a small chunk of text during the printing process. I enabled the debugging statements and found that this is occurring when > 40 bytes are sent to the printer from the script, despite the MAXLEN value of 40. If I understand it correctly, the printer is still handling the first 40 (of about 63 in the case I found) and then going on to the next 40, ignoring the 23 extra bytes. Any idea why this might be occurring?

Thread 14 (2020-10-21):

unicode strings not supported on MacOS

ffd8, 2020-10-21:
Perhaps I'm making an amateur mistake... have the Nano + hardware all setup onan IBM 6747-2, but running into trouble while trying to test with your python scripts on MacOS 10.13.6, getting the following error (i'm using a nano clone, but that shouldn't be the issue, since code uploaded without problem):

```
➜  python_scripts python actualTypewriterNano.py
Please choose a port:
	1) /dev/tty.Bluetooth-Incoming-Port
	2) /dev/tty.wchusbserial1430
2
Traceback (most recent call last):
  File "actualTypewriterNano.py", line 104, in <module>
    ser.write(chr(event))  # send one byte
  File "/usr/local/lib/python3.7/site-packages/serial/serialposix.py", line 532, in write
    d = to_bytes(data)
  File "/usr/local/lib/python3.7/site-packages/serial/serialutil.py", line 63, in to_bytes
    raise TypeError('unicode strings are not supported, please encode to bytes: {!r}'.format(seq))
TypeError: unicode strings are not supported, please encode to bytes: 'h'
```

Is it because I'm using python 3? (i'm not so familiar with python...) – also tried just your `testSend.py`, but get the following similar error:
```
python_scripts python testSend.py
Traceback (most recent call last):
  File "testSend.py", line 13, in <module>
    ser.write(a)
  File "/usr/local/lib/python3.7/site-packages/serial/serialposix.py", line 532, in write
    d = to_bytes(data)
  File "/usr/local/lib/python3.7/site-packages/serial/serialutil.py", line 63, in to_bytes
    raise TypeError('unicode strings are not supported, please encode to bytes: {!r}'.format(seq))
TypeError: unicode strings are not supported, please encode to bytes: '\x1e\x00abcdefghijklmnopqrstuvwxyz\nabc'
```

Do you know a solution? Have you considered making a basic demo for talking to the Nano controller via Processing?? That's more my strength.. have done serial for plotters + thermal printers.. so I'll explore that next, but curious if you already had any tests laying around to get started?

ffd8, 2020-10-21:
Ahha.. found two problems!
- I had miswired one cable to the MOSFET = my bad....
- in many of the example scripts in `/software`, the baudrate was set to `57600` whereas in the arduino code, it's set to `115200`...

Tried changing some of the python scripts to use `.encode()` on strings for unicode.. but then the `actualTypewriter.py` script could only write one char before quitting with an error of: `TypeError: a bytes-like object is required, not 'str'`

Starting to play in Processing and successfully have really basic typewriter(!) without any bells/whistles using:

```
import processing.serial.*;

Serial myPort;  // Create object from Serial class
int val;        // Data received from the serial port

void setup()
{
  size(200, 200);
  myPort = new Serial(this, "/dev/cu.wchusbserial1430", 115200);
}

void keyPressed() {
  if(keyCode != 16){
    myPort.write(key+"");
  }
}

void draw() {
  if ( myPort.available() > 0) {  // If data is available,
    val = myPort.read();         // read it and store it in val
    println(val);
  }
}

```

Thread 15 (2021-07-15):

Send event codes / actualTypewriterNano.py

seniZH, 2021-07-15:
Thanks for the very nice project :) I can now use my WW5 as a printer for my Arduino projects :)

As I'm not a pro in Python yet, I have some problems to send the event codes (e.g. for bold) through the terminal... for: software/python_scripts/actualTypewriterNano.py

How can I trigger the event 21, or 2?
Sorry for my question, I guess, it is very simple... But all my tries and www searches failed... :(

I can start the program with mac terminal and also writing in the editor screen is possible without problem, but only "normal" text without bold, underline...

**elif event == 21:**
                screen.addstr('(underline)')
                event = 3 # convert to code for underline

**elif event == 2:**
                screen.addstr('(bold)')

Thank you very much

Thread 16 (2021-10-12):

Could we get an oscilloscope bus capture?

rsaxvc, 2021-10-12:
This is super cool.

Do you have a plot from a logic analyzer or oscilloscope? Could it possibly be a UART with odd baud rate? That might explain the 10 bit frames if in 8N1, or a 7 bit plus parity.

Patagonicus, 2022-01-05:
So, I just got my (very cheap) digital logic analyzer, still trying to wrap my head around things. From what I can tell, UART with 9 data bits, no stop bits and no parity at 187300 Hz (based on the 5.34us pulse period from the readme) seems to work - at least it decodes blocks of 9 bits quite well. I have a Swiss Wheelwriter 6747-2. Here's a capture of what happened on the bus when I pressed "a" without modifiers:
[wheelwriter-6747-2-ch-a.zip](https://github.com/tofergregg/IBM-Wheelwriter-Hack/files/7817254/wheelwriter-6747-2-ch-a.zip) (this is what Sigrok Pulseview spat out via "Save Selected Range as")

Haven't cross-referenced it yet / figured out what the parts mean. Let me know if you want me to capture specific bits and I'll try to get around to it in the next few weeks.

Patagonicus, 2022-01-05:
Ok, I went through it while looking at https://github.com/RussellSenior/IBM-Wheelwriter-Hack/wiki/Bus-Protocol

The trace I had posted above was a bit special because it was at the beginning of the line or something similar.
[Here's one pressing "e"](https://github.com/tofergregg/IBM-Wheelwriter-Hack/files/7817364/wheelwriter-6747-2-ch-e.zip). You can extract the raw bus data via `sigrok-cli -i wheelwriter-6747-2-ch-e.sr -P uart:rx=D0:baudrate=187500:data_bits=9 | sed -n '/^uart-1: ...$/{s/^uart-1: //;p;}'` (there might be a better way than using sed for filtering the right lines, but I haven't looked into that yet).

rsaxvc, 2022-01-06:
Thanks! I came up with 185567 kbps from your captures by averaging over all bits in a byte - pretty close, and UART only needs to be close enough.

It does look like UART. I tried 8-bit plus each different parity setting, but everything resulted in at least one parity-error.

So far, all the bytes I've seen have space for 1-stop-bit, did you spot anything that made you consider 0?

Anyways, just the fact that it's logically 9-bit UART compatible opens up a lot of options - many ATMega-based Arduinos would be able to reach near this baud rate and support a 9-bit mode. I was hoping I could interface it easily to an ESP8266, but it seems that UART is limited to 5/6/7/8 bits with optional parity. You could transmit this 9-bit pattern using an 8-bit UART and adjusting parity each time, but it wouldn't work to receive. Thanks again!

Patagonicus, 2022-01-06:
Ah, you're right, it could be 1 stop bit as well. From what I can tell it's always one word sent by the computer unit followed by one word by the type head, so there's >1 bit delay in between words since they need to process what they've read first. That probably also means you can't send faster than that since otherwise there'll be a collision with the reply from the type head.

rsaxvc, 2022-01-06:
I'm curious if there's any CTS-style signal available to tell when it's ready again.

tofergregg, 2022-01-06:
I don't think there is. It is a very simple bus.

Patagonicus, 2022-01-06:
Any idea what the other pins on the connector are for? They seem to be labeled BRQ, POR, VRM (or WRM?) and PDI on my machine (the 6747-2 responds with the number for a Wheelwriter 6, btw. I somehow thought it was the related to a 5, but apparently not).

I'll have to check if they are also 0V-5V. If so, I'll hook them up to the analyzer to see if I can find any correlations.

But, from what I can, the way it works is just that the computing unit sends a word, then waits for the typing head to respond. For some things that seems to be how it figures out the head has finished what it's supposed to do - the computing unit sends 0x121, which is the address of the head, then waits for a null byte to be returned.

Closed 2022-01-06.

Thread 17 (2024-01-19):

Character Order Information

GhostBeee, 2024-01-19:
Hi Chris,

I know this is info far after your project has likely concluded, but a few of my students and I decided to start a similar project, and I found your github.

We discovered that the letters are in a clever order, but it doesn't really make sense unless you look at the daisywheel directly. The wheel always defaults to lower case 'a', which is 0x01. I was confused when I saw lower case 'n' was next, since I figured it would be in "most used character" order to save on movement, but lower case 'e' was 0x60.

Turns out, it is in most used character order, but you have to look at their proximity on the daisywheel (rudimentary drawing below):

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

The most common characters are near at the beginning (a, n, r etc.), at the middle are the least common (numbers, mathematical operators and symbols, w, x etc.), then at the end are the more common letters again (e, o, j etc.).

Thought you may be interested in that info when talking about the project.

-Tim

UCLA Assistant Makerspace Manager

tofergregg, 2024-01-20:
Hi Tim! Thanks for your note! Great job to you and your students for figuring that out -- I've had a couple other people email me over the years about it, and I considered updating the README, but I like that it is a bit of an Easter egg to figure out. You and your students actually have provided more detail than anyone else -- awesome. Cheers!
