tofergregg/IBM-Wheelwriter-Hack/(list of files, drawings)

Other design files:
hardware/WheelwriterBreadboard.fzz
