tofergregg/IBM-Wheelwriter-Hack/hardware/IBM_Wheelwriter/wheelwriter.brd

## EAGLE design hardware/IBM_Wheelwriter/wheelwriter.brd (2017-02-04)

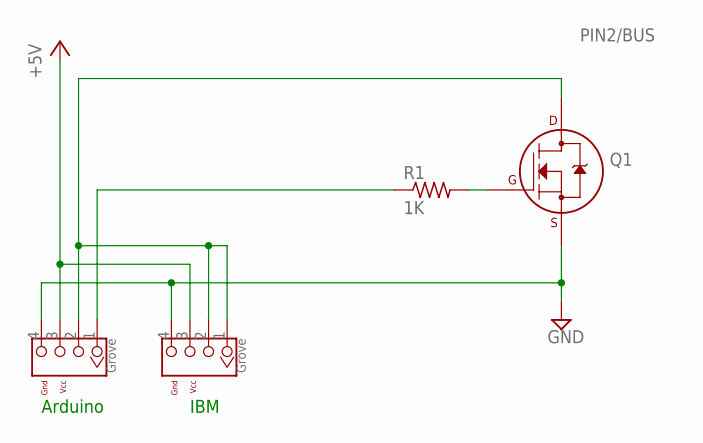
[picture p20: schematic wheelwriter.sch]

Parts:
J1, J2: TWIG-4P-2.090D; 4P-2.0-90D
Q1: 2N7002A_SOT23; SOT-23
R1: 1K; R1206

Connections:
+5V: J2.3
GND: J1.4, J2.4, Q1.2 (S)
unnamed: Q1.1 (G), R1.2
unnamed: J1.1, R1.1
PIN2/BUS: J1.2, J2.1, J2.2, Q1.3 (D)

Notes on the sheet:
Arduino
IBM

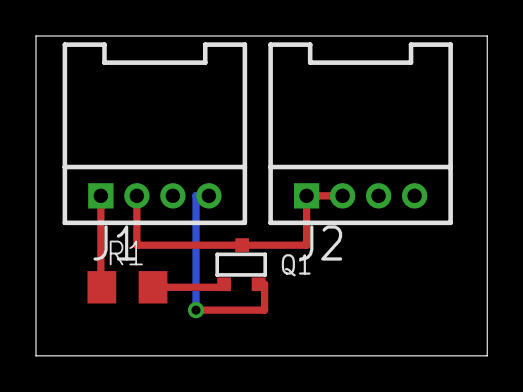
[picture p21: board wheelwriter.brd from above]

Board: 2 copper layers, 25.1 x 17.8 mm, 4 parts (0 on the bottom side), 4 nets.
