tofergregg/IBM-Wheelwriter-Hack/(commit log)

2016-12-17 non-working controller with interrupt for pin
2016-12-17 non-working controller without interrupt
2016-12-17 working except for return not using interrupts
2016-12-17 added print_strln() function
2016-12-18 bean program now prints one character at a time when receiving from serial
2016-12-18 updated programs for minor fixes
    [actualTypewriter.py, beanWheelwriterControl.ino, textToBean.py]
2017-01-01 wheelwriter control before updating to remove queue
2017-01-01 updated control program to print up to 60 characters at a time
2017-01-16 Added Arduino Nano code and schematics
    [Arduino_Nano.kicad_pcb, Arduino_Nano.sch, ArudinoPCB.kicad_pcb, ArudinoPCB.sch]
2017-01-20 updated nano printing for graphics
2017-01-20 renamed Nano wheelwriter arduino program
2017-02-04 first attempt at word processor for typewriter, mac os
    [1-0.csv, 1234567890Ret.csv, 13aBeanTest.csv, 13aTypewriter.csv, 2x2.csv, A-Z.csv, I1.csv, a1.csv]
2017-02-08 added graphics printing to Mac program. Still working on printing both text and graphics
2017-02-08 added breadboard image and Fritzing file
    [WheelwriterBreadboard.fzz]
2017-02-08 updated README to include breadboard
    [WheelwriterBreadboard.fzz]
2017-02-08 updated breadboard image
    [WheelwriterBreadboard.fzz]
2017-02-08 updated breadboard image and readme
    [WheelwriterBreadboard.fzz]
2017-02-09 fixed issue with printing images
    [WheelwriterControlNano.ino]
2017-02-09 re-organized github
    [1-0.csv, 1234567890Ret.csv, 13aBeanTest.csv, 13aTypewriter.csv, 2x2.csv, A-Z.csv, Arduino_Nano.kicad_pcb, Arduino_Nano.sch]
2017-02-18 added case images for nano and shield for laser cutting
2017-02-18 working on reverse text
    [WheelwriterControlNano.ino]
2018-07-06 reset WheelwriterControlNano.ino to original
    [WheelwriterControlNano.ino]
2018-07-06 updated textWithSpaces to put value in twos complement, and updated arduino sketch to accomodate this
2018-07-06 added resetTypewriter.py and returnCursor.py
    [availablePorts.py, moveCursor.py, resetTypewriter.py, returnCursor.py, textWithSpaces.py]
2018-07-09 updated server and arduino to receive and send null terminator
2019-01-29 added printer escape code examples for wheelwriter 10/15 printer option
2019-01-29 added ROM info
    [flatflex_passthrough.kicad_pcb, flatflex_passthrough.sch]
2019-01-29 updated wheelwriter 10/15 printer option info
2019-04-14 fixed microspacing for bold and underline
    [WheelwriterControlNano.ino, send_command.py, server.py]
2019-04-14 updated letter and fixed server issue
    [server.py]
